suneids/Hexapod/3d models/Hexapod.FCStd

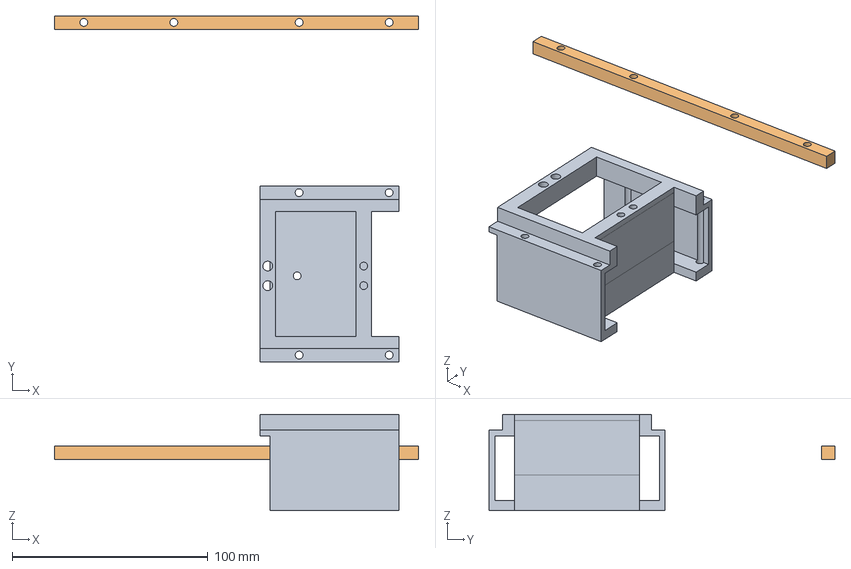
[picture p1: CAD file, 2026-11-06]
3d models/Hexapod.FCStd
186.0 x 176.8 x 49.1 mm
V004
Соединения посадочных мест ног001
