suneids/Hexapod/3d models/hexapod_coxa_socket.stl

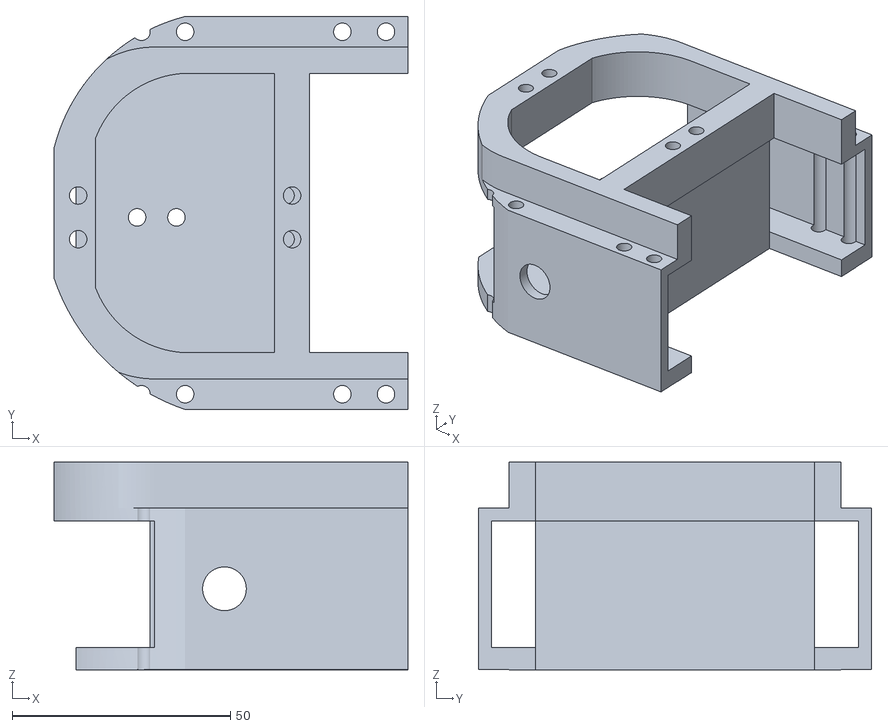
[picture p2: CAD file, 2026-11-06]
3d models/hexapod_coxa_socket.stl
81.0 x 90.0 x 47.6
