suneids/Hexapod/3d models/Hexapod-Соха.stl

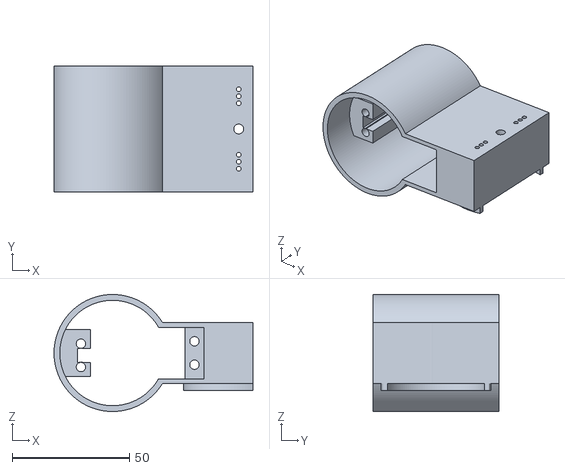
[picture p3: CAD file, 2026-11-06]
3d models/Hexapod-Соха.stl
85.0 x 54.0 x 50.0
