suneids/Hexapod/3d models/Паук.FCStd

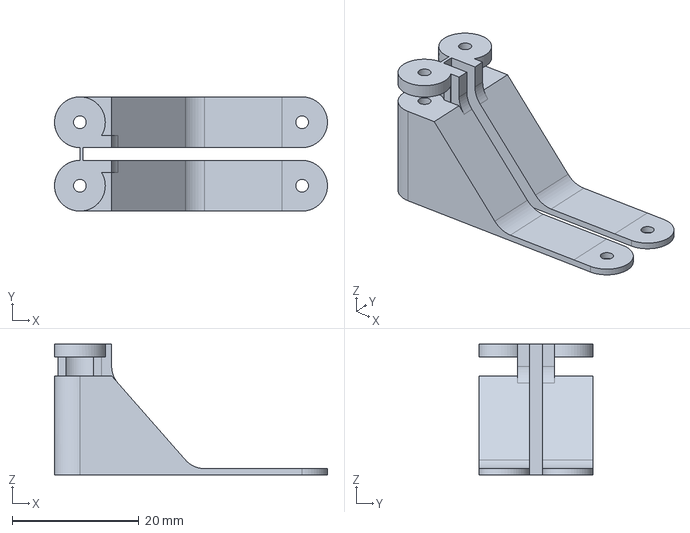
[picture p4: CAD file, 2026-10-03]
3d models/Паук.FCStd
43.0 x 18.0 x 20.6 mm
