suneids/Hexapod/(list of files, cad)

Other CAD files:
3d models/Hexapod.blend
