suneids/Hexapod/electronics/Hexapod/Hexapod_Leg.kicad_sch

## KiCad design electronics/Hexapod/Hexapod_Leg.kicad_sch (2026-10-03)

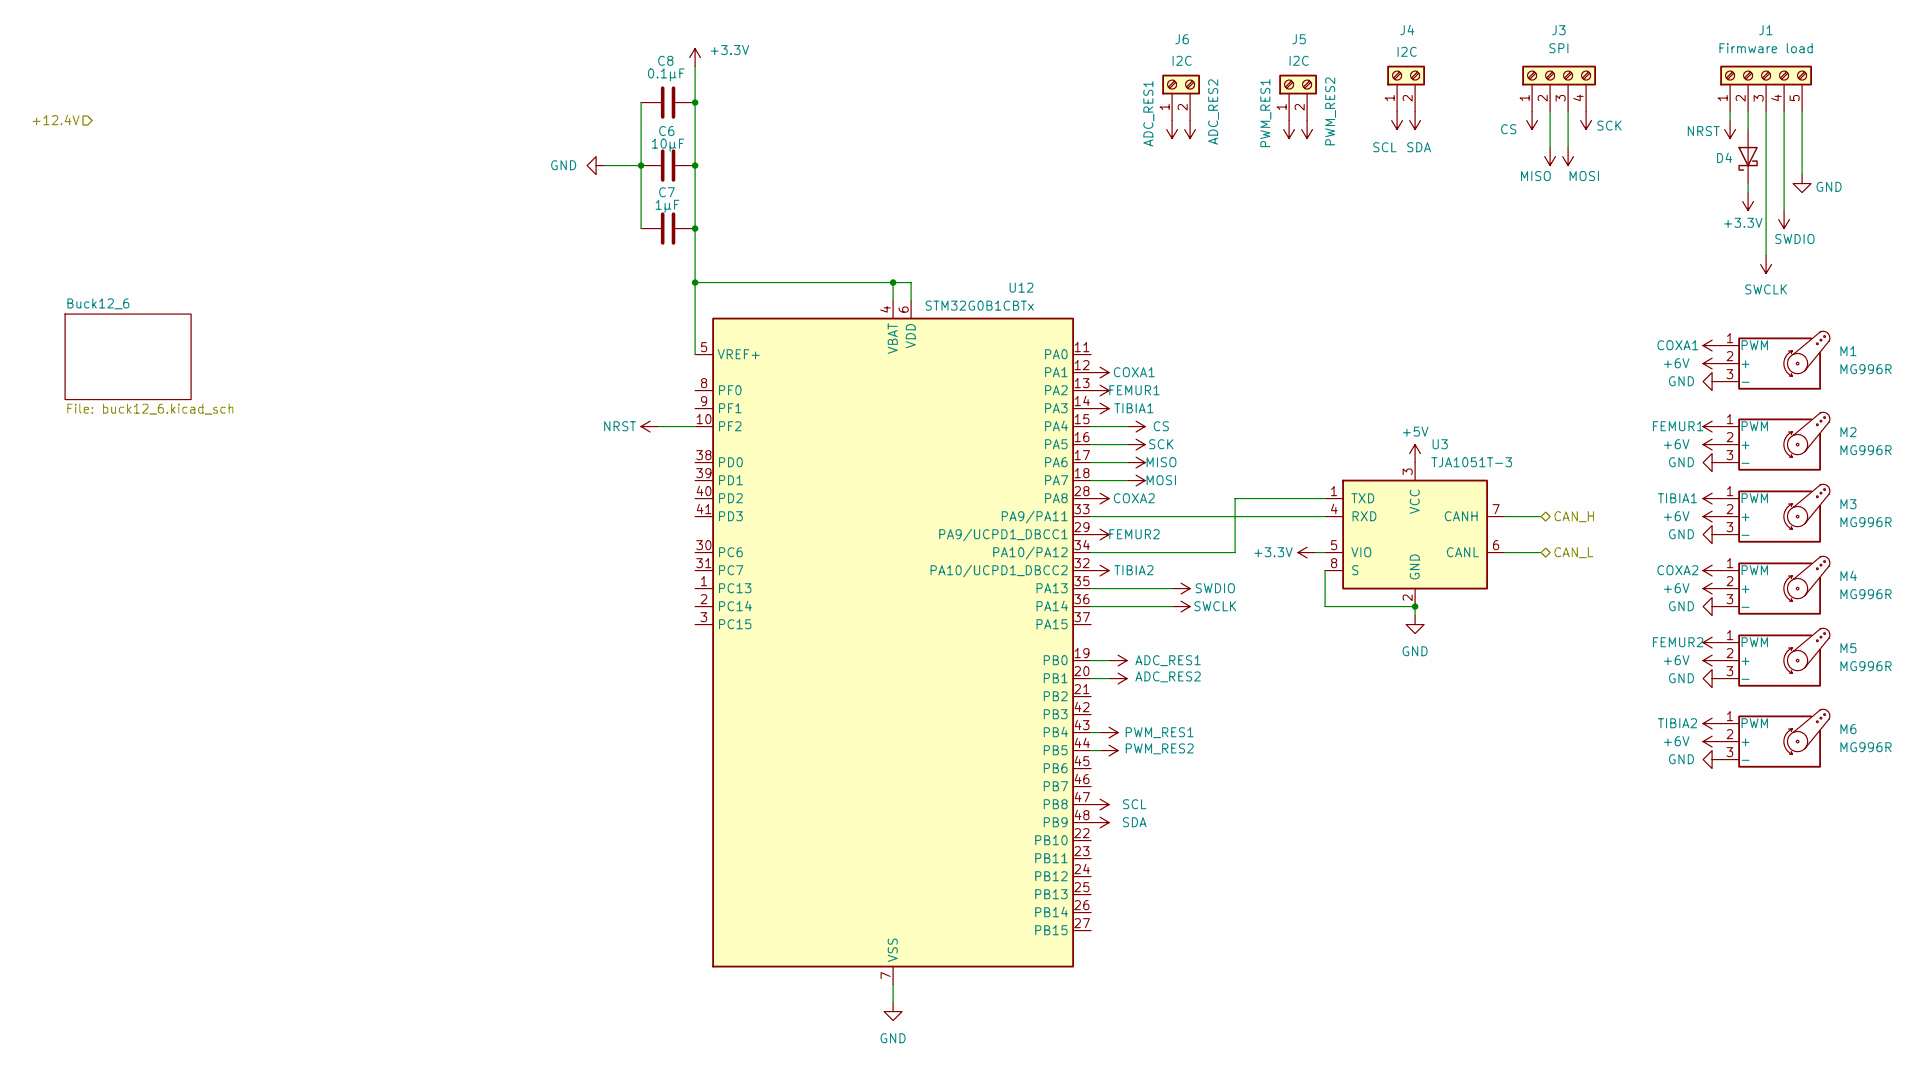
[picture p5: schematic Hexapod_Leg.kicad_sch]

Parts:
C6: 10µF; C_0603_1608Metric
C7: 1µF; C_0603_1608Metric
C8: 0.1µF; C_0603_1608Metric
D4: +3.3V; Nexperia_CFP3_SOD-123W
J1: Firmware load; PinHeader_1x05_P2.54mm_Vertical
J3: SPI
J4, J5, J6: I2C
M1, M2, M3, M4, M5, M6: MG996R
U3: TJA1051T-3; SOIC-8_3.9x4.9mm_P1.27mm
U12: STM32G0B1CBTx; LQFP-48_7x7mm_P0.5mm

Connections:
+3.3V: C6.1, C7.1, C8.2, D4.1 (K), U3.5 (VIO), U12.4 (VBAT), U12.5 (VREF+), U12.6 (VDD)
+5V: U3.3 (VCC)
+6V: M1.2 (+), M2.2 (+), M3.2 (+), M4.2 (+), M5.2 (+), M6.2 (+)
ADC_RES1: J6.1, U12.19 (PB0)
ADC_RES2: J6.2, U12.20 (PB1)
CAN_H: U3.7 (CANH)
CAN_L: U3.6 (CANL)
COXA1: M1.1 (PWM), U12.12 (PA1)
COXA2: M4.1 (PWM), U12.28 (PA8)
CS: J3.1, U12.15 (PA4)
FEMUR1: M2.1 (PWM), U12.13 (PA2)
FEMUR2: M5.1 (PWM), U12.29 (PA9/UCPD1_DBCC1)
GND: C6.2, C7.2, C8.1, J1.5, M1.3 (-), M2.3 (-), M3.3 (-), M4.3 (-), M5.3 (-), M6.3 (-), U3.2 (GND), U3.8 (S), U12.7 (VSS)
MISO: J3.2, U12.17 (PA6)
MOSI: J3.3, U12.18 (PA7)
NRST: J1.1, U12.10 (PF2)
unnamed: D4.2 (A), J1.2
unnamed: U3.4 (RXD), U12.33 (PA9/PA11)
unnamed: U3.1 (TXD), U12.34 (PA10/PA12)
PWM_RES1: J5.1, U12.43 (PB4)
PWM_RES2: J5.2, U12.44 (PB5)
SCK: J3.4, U12.16 (PA5)
SCL: J4.1, U12.47 (PB8)
SDA: J4.2, U12.48 (PB9)
SWCLK: J1.3, U12.36 (PA14)
SWDIO: J1.4, U12.35 (PA13)
TIBIA1: M3.1 (PWM), U12.14 (PA3)
TIBIA2: M6.1 (PWM), U12.32 (PA10/UCPD1_DBCC2)
