suneids/Hexapod/electronics/Hexapod/buck12_6.kicad_sch

## KiCad design electronics/Hexapod/buck12_6.kicad_sch (2026-10-03)

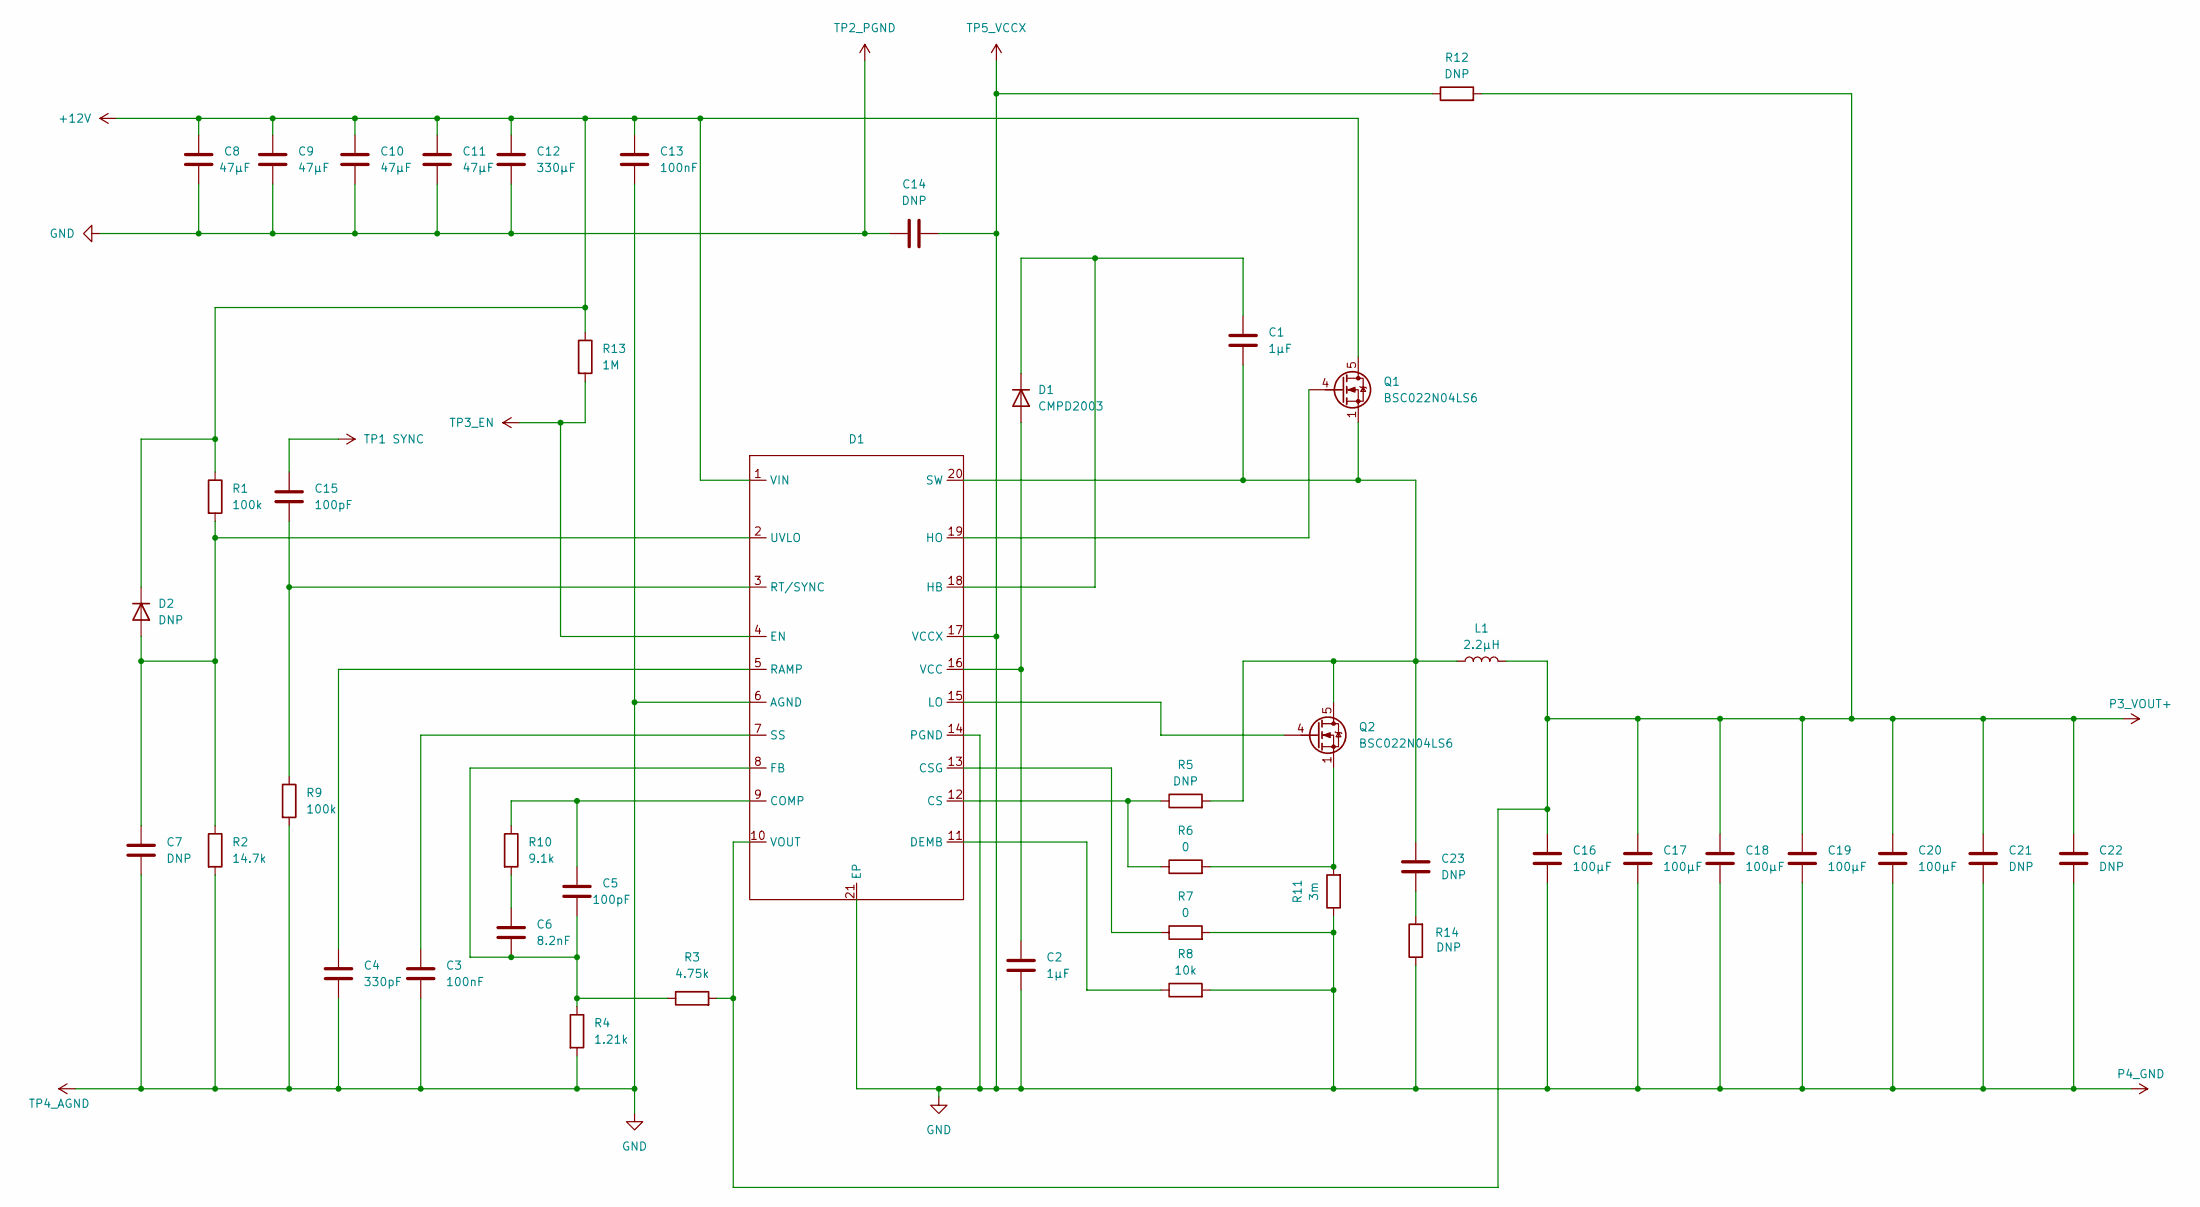
[picture p6: schematic buck12_6.kicad_sch]

Parts:
C1, C2: 1µF
C3, C13: 100nF
C4: 330pF
C5, C15: 100pF
C6: 8.2nF
C7, C14, C21, C22, C23: DNP
C8, C9, C10, C11: 47µF
C12: 330µF
C16, C17, C18, C19, C20: 100µF
D1: CMPD2003
D2: DNP; D_DO-35_SOD27_P7.62mm_Horizontal
L1: 2.2µH
Q1, Q2: BSC022N04LS6; TDSON-8-1
R1, R9: 100k
R2: 14.7k
R3: 4.75k
R4: 1.21k
R5, R12, R14: DNP
R6, R7: 0
R8: 10k
R10: 9.1k
R11: 3m
R13: 1M

Connections:
+12V: C8.1, C9.1, C10.1, C11.1, C12.1, C13.1, D1.1 (VIN), D2.1 (K), Q1.5 (D), R1.1, R13.1
GND: C2.1, C3.2, C4.2, C7.1, C8.2, C9.2, C10.2, C11.2, C12.2, C13.2, C14.1, C14.2, C16.1, C17.1, C18.1, C19.1, C20.1, C21.1, C22.1, D1.6 (AGND), D1.14 (PGND), D1.17 (VCCX), D1.21 (EP), R2.2, R4.2, R7.2, R8.2, R9.2, R11.1, R12.1, R14.1
unnamed: C1.1, C23.2, D1.20 (SW), L1.1, Q1.1 (S), Q1.2 (S), Q1.3 (S), Q2.5 (D), R5.2
unnamed: C1.2, D1.1 (VIN), D1.18 (HB)
unnamed: C2.2, D1.2 (UVLO), D1.16 (VCC)
unnamed: C3.1, D1.7 (SS)
unnamed: C4.1, D1.5 (RAMP)
unnamed: C5.1, D1.9 (COMP), R10.1
unnamed: C5.2, C6.2, D1.8 (FB), R3.1, R4.1
unnamed: C6.1, R10.2
unnamed: C7.2, D1.2 (UVLO), D2.2 (A), R1.2, R2.1
unnamed: C15.2, D1.3 (RT/SYNC), R9.1
unnamed: C23.1, R14.2
unnamed: D1.11 (DEMB), R8.1
unnamed: D1.12 (CS), R5.1, R6.1
unnamed: D1.13 (CSG), R7.1
unnamed: D1.15 (LO), Q2.4 (G)
unnamed: D1.19 (HO), Q1.4 (G)
unnamed: Q2.1 (S), Q2.2 (S), Q2.3 (S), R6.2, R11.2
P3_VOUT+: C16.2, C17.2, C18.2, C19.2, C20.2, C21.2, C22.2, D1.10 (VOUT), L1.2, R3.2, R12.2
TP1 SYNC: C15.1
TP3_EN: D1.4 (EN), R13.2
