suneids/Hexapod/app/firmware/Brain/Src/main.c

#include "activities.h"

int main(void){

	BRAIN_Init();
	uint32_t state_time = millis();
	SPIDER_StepBase();
    while(7){
    	Control_Update();
		SPIDER_GaitUpdate();
		Leg_Motion_Update();
    	if(millis() - state_time > 200){
    		BRAIN_SendCurrentState();
    		state_time = millis();
    	}
    }
}
