suneids/Hexapod/app/firmware/inc/HAL_STM32F103C6T6/inc/soft_i2c.h

#ifndef SOFT_I2C_H
#define SOFT_I2C_H
#define I2C_DELAY() for(volatile int i=0; i < 5000; i++)
#include "gpio.h"
void SoftI2C_Start(GPIO_Pin_t sda, GPIO_Pin_t scl);
void SoftI2C_Stop(GPIO_Pin_t sda, GPIO_Pin_t scl);
uint8_t SoftI2C_Write(GPIO_Pin_t sda, GPIO_Pin_t scl, uint8_t byte);
uint8_t SoftI2C_Read(GPIO_Pin_t sda, GPIO_Pin_t scl, uint8_t ack);

#endif
