suneids/Hexapod/(commit log)

2026-08-12 One leg G0
2026-10-03 Service instead of huge app
    [Hexapod.blend, Hexapod.kicad_pcb, Hexapod.kicad_sch, Hexapod_Leg.kicad_sch, buck12_6.kicad_sch, Паук.FCStd]
2026-11-06 Leg deleted
